jOaSbA/Impedantie-onafhankelijke-stroombron-ontvanger/Images/20260116_134800.jpg

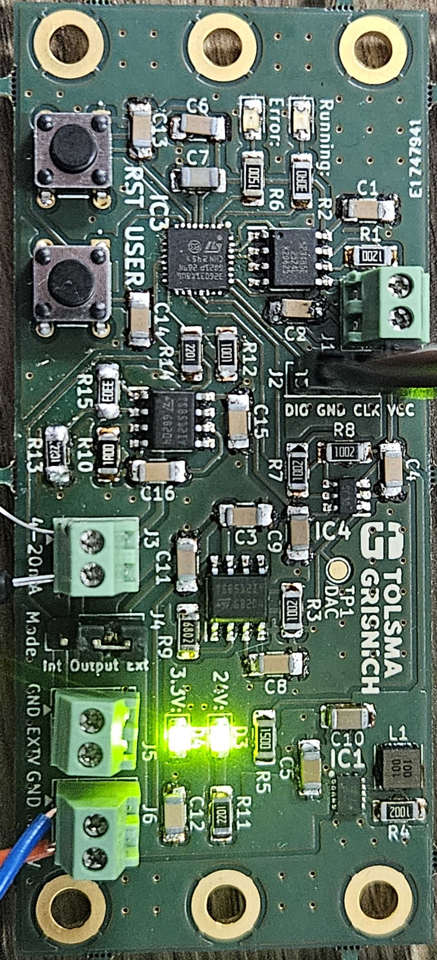
Images/20260116_134800.jpg
