jOaSbA/Impedantie-onafhankelijke-stroombron-ontvanger/README.md

"# Impedantie-onafhankelijke-stroombron-ontvanger"
