jOaSbA/Impedantie-onafhankelijke-stroombron-ontvanger/(list of files, drawings)

Other design files:
KiCad/freerouting.dsn
KiCad/temp-freerouting.dsn
