jOaSbA/Impedantie-onafhankelijke-stroombron-ontvanger/KiCad/Tolsma-Grisnich_4-20mAstrmbrn.kicad_pcb

## KiCad design KiCad/Tolsma-Grisnich_4-20mAstrmbrn.kicad_pcb (2026-01-16)

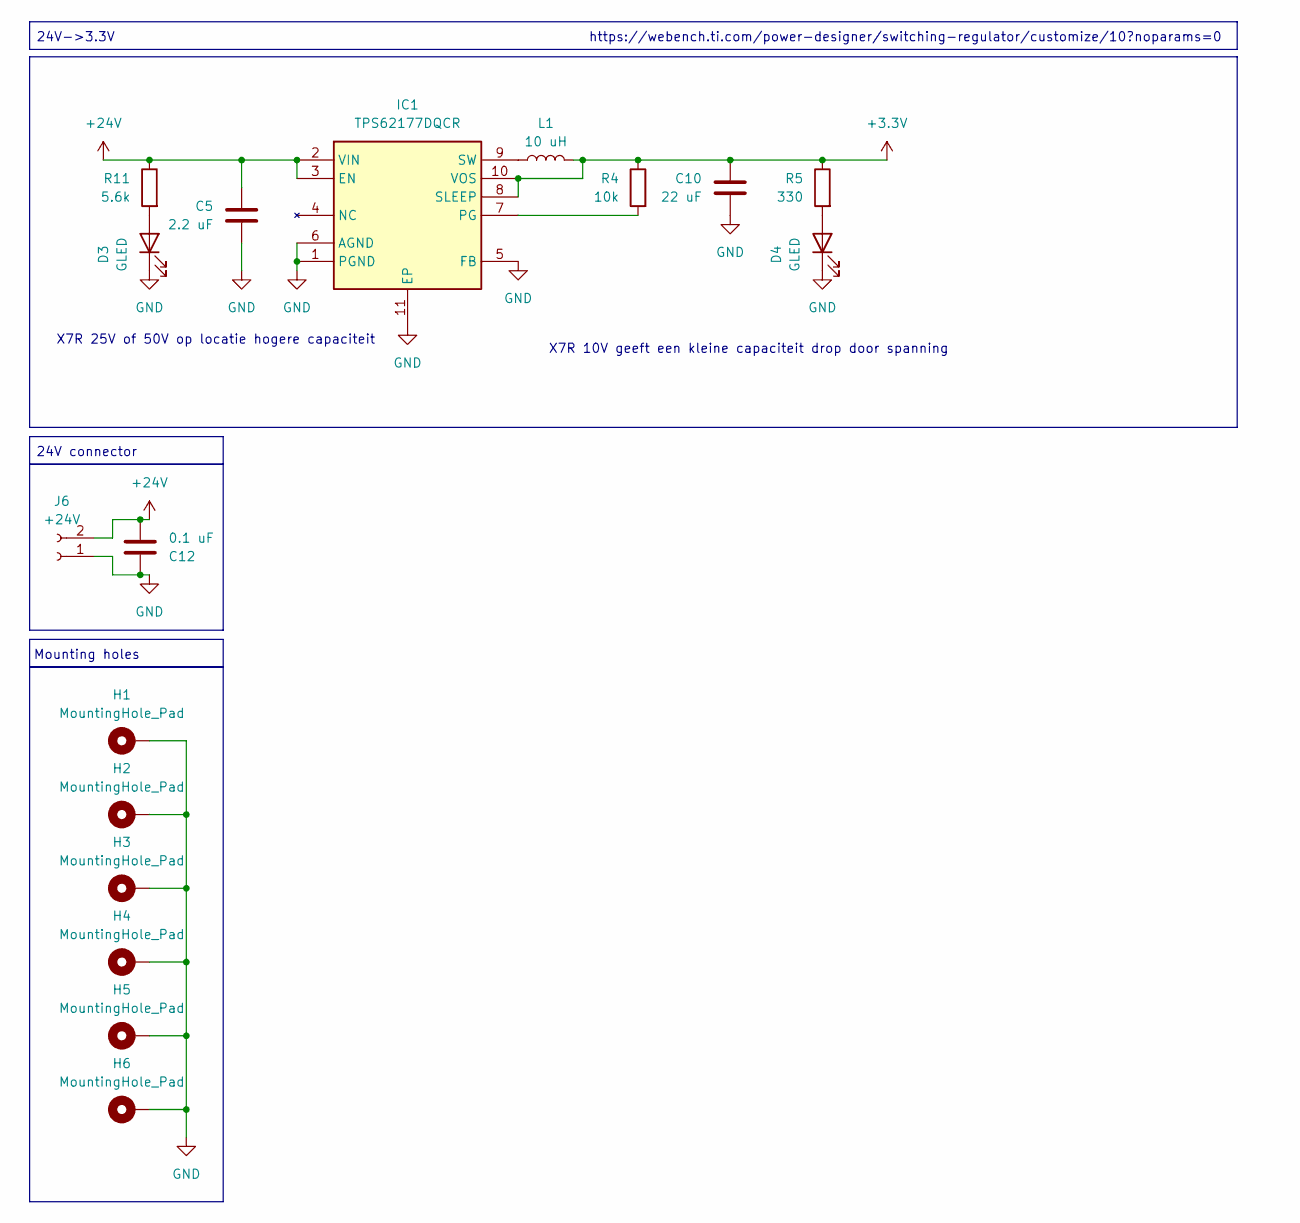
[picture p2: schematic Power.kicad_sch]

Parts:
C5: 2.2 uF; C_1206_3216Metric_Pad1.33x1.80mm_HandSolder
C10: 22 uF; C_1206_3216Metric_Pad1.33x1.80mm_HandSolder
C12: 0.1 uF; C_1206_3216Metric_Pad1.33x1.80mm_HandSolder
D3, D4: GLED; LED_0805_2012Metric_Pad1.15x1.40mm_HandSolder
H1, H2, H3, H4, H5, H6: MountingHole_Pad; MountingHole_3.2mm_M3_DIN965_Pad
IC1: TPS62177DQCR; SON50P200X300X80-11N; Mouser Part Number 595-TPS62177DQCR
J6: +24V; TerminalBlock_Xinya_XY308-2.54-2P_1x02_P2.54mm_Horizontal
L1: 10 uH; L_Wuerth_MAPI-3015
R4: 10k; R_1206_3216Metric_Pad1.30x1.75mm_HandSolder
R5: 330; R_1206_3216Metric_Pad1.30x1.75mm_HandSolder
R11: 5.6k; R_1206_3216Metric_Pad1.30x1.75mm_HandSolder

Connections:
+3.3V: C10.1, IC1.8 (SLEEP), IC1.10 (VOS), L1.2, R4.1, R5.1; also elsewhere on the board
+24V: C5.1, C12.2, IC1.2 (VIN), IC1.3 (EN), J6.2, R11.1; also elsewhere on the board
GND: C5.2, C10.2, C12.1, D3.1 (K), D4.1 (K), H1.1, H2.1, H3.1, H4.1, H5.1, H6.1, IC1.1 (PGND), IC1.5 (FB), IC1.6 (AGND), IC1.11 (EP), J6.1; also elsewhere on the board
unnamed: D3.2 (A), R11.2
unnamed: D4.2 (A), R5.2
unnamed: IC1.7 (PG), R4.2
unnamed: IC1.9 (SW), L1.1

Notes on the sheet:
X7R 10V geeft een kleine capaciteit drop door spanning
24V connector
24V->3.3V
Mounting holes
X7R 25V of 50V op locatie hogere capaciteit
https://webench.ti.com/power-designer/switching-regulator/customize/10?noparams=0

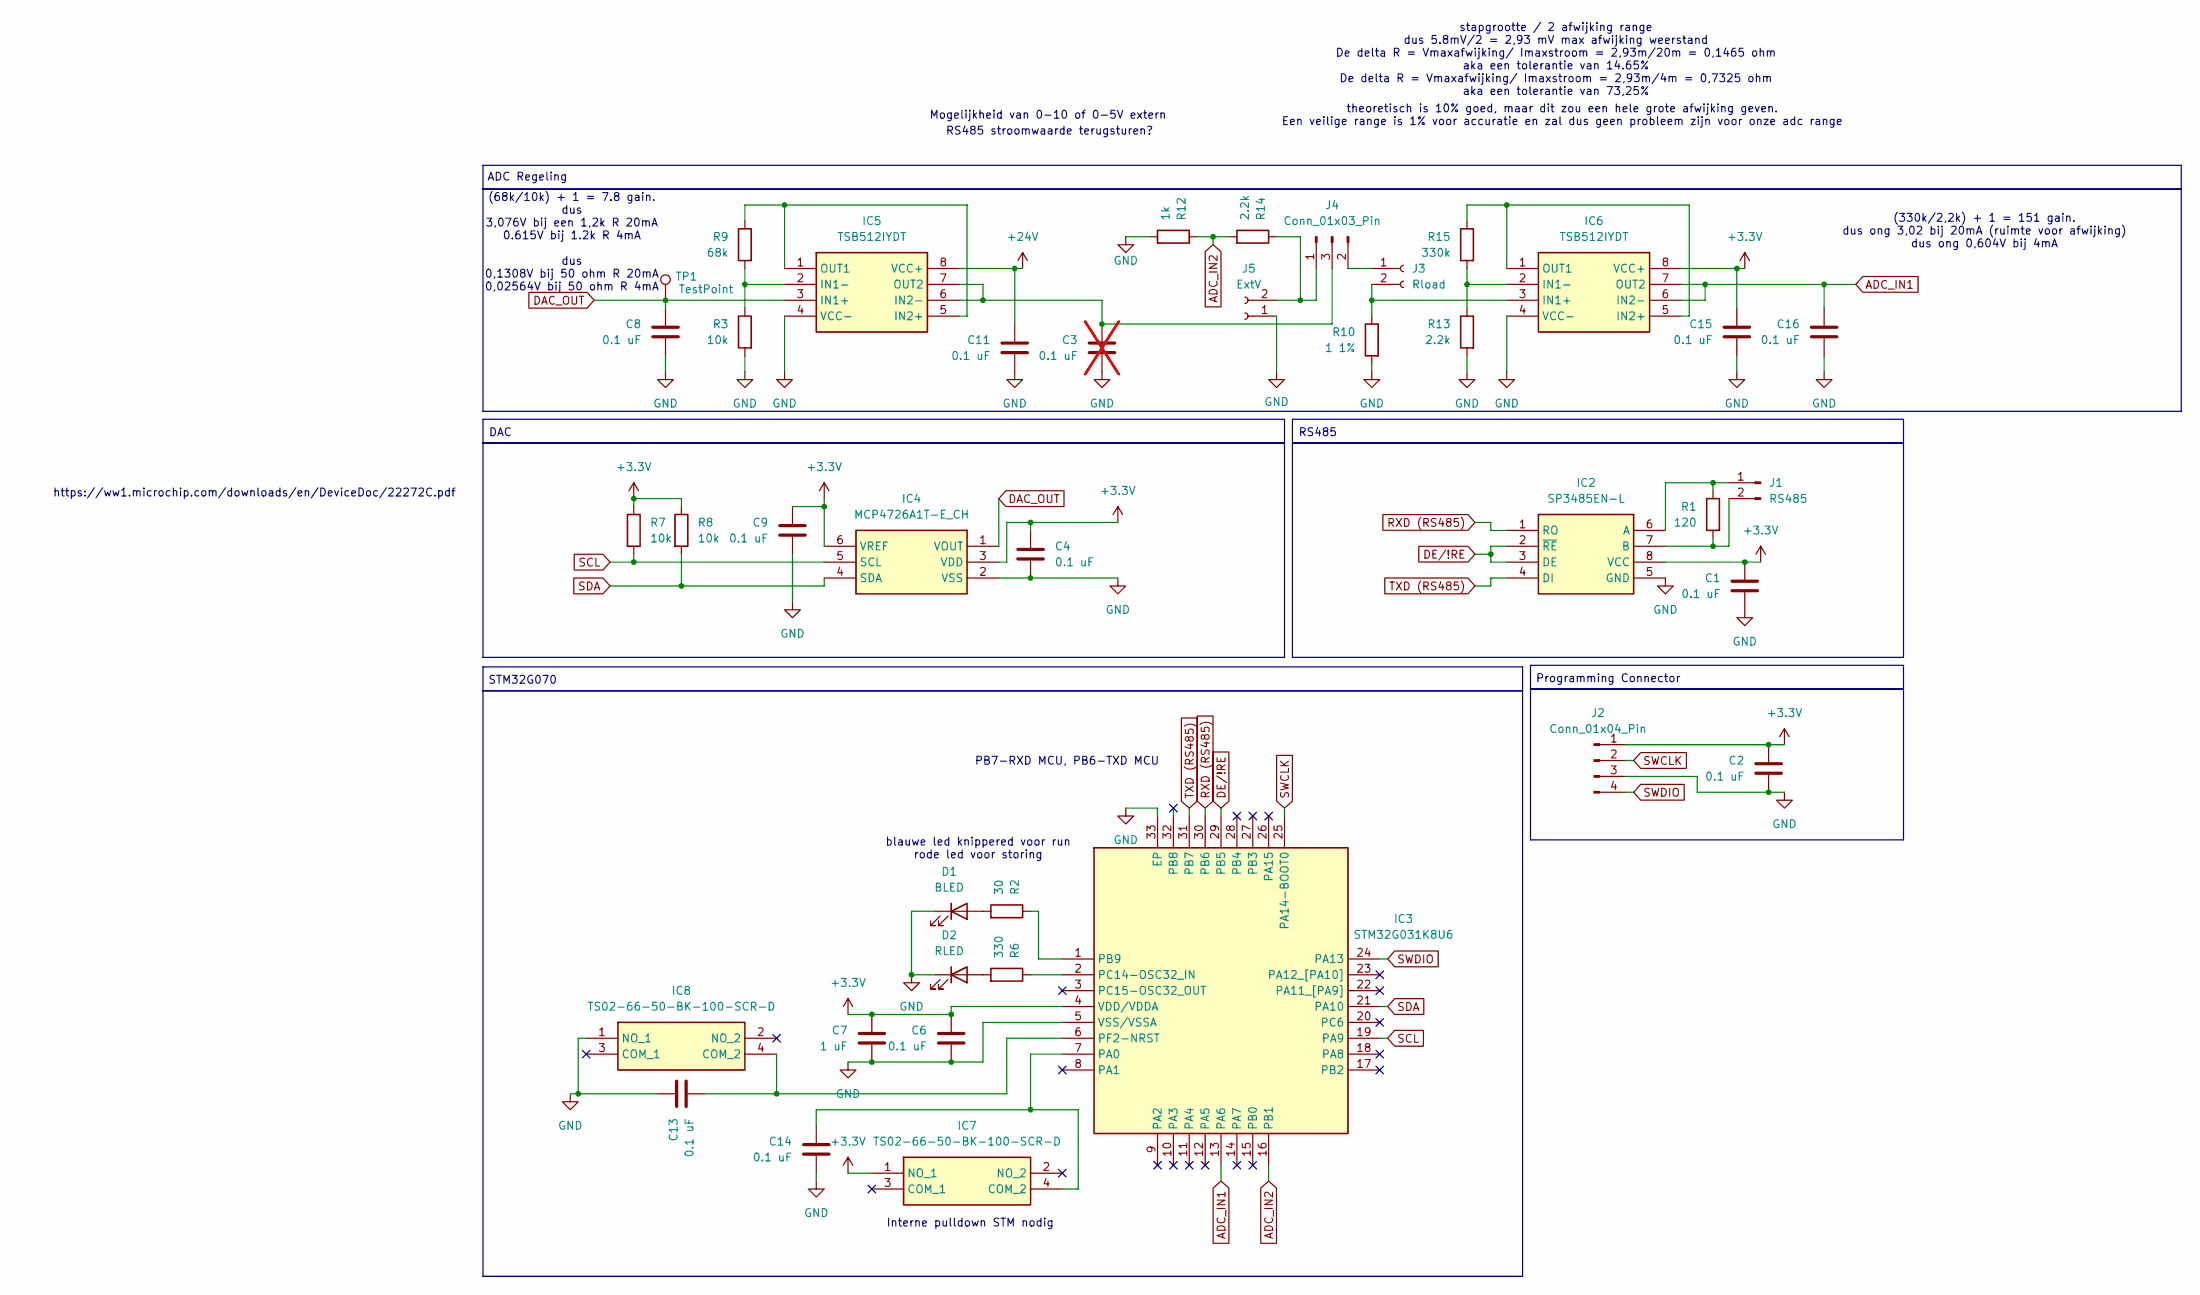
[picture p3: schematic Logic.kicad_sch]

Parts:
C1, C2, C4, C6, C8, C9, C11, C13, C14, C15, C16: 0.1 uF; C_1206_3216Metric_Pad1.33x1.80mm_HandSolder
C3: 0.1 uF; C_1206_3216Metric_Pad1.33x1.80mm_HandSolder; not fitted
C7: 1 uF; C_1206_3216Metric_Pad1.33x1.80mm_HandSolder
D1: BLED; LED_0805_2012Metric_Pad1.15x1.40mm_HandSolder
D2: RLED; LED_0805_2012Metric_Pad1.15x1.40mm_HandSolder
IC2: SP3485EN-L; SOIC127P600X175-8N; Manufacturer_Part_Number SP3485EN-L; Mouser Part Number 701-SP3485EN-L
IC3: STM32G031K8U6; QFN50P500X500X60-33N-D; Mouser Part Number 511-STM32G031K8U6
IC4: MCP4726A1T-E_CH; SOT95P270X145-6N; Manufacturer_Part_Number MCP4726A1T-E/CH; Mouser Part Number 579-MCP4726A1TECH
IC5, IC6: TSB512IYDT; SOIC127P600X175-8N; Manufacturer_Part_Number TSB512IYDT; Mouser Part Number 511-TSB512IYDT
IC7, IC8: TS02-66-50-BK-100-SCR-D; TS026650BK100SCRD; Mouser Part Number 179-TS026650BK100SCR
J1: RS485; TerminalBlock_Xinya_XY308-2.54-2P_1x02_P2.54mm_Horizontal
J2: Conn_01x04_Pin; PinHeader_1x04_P2.54mm_Vertical
J3: Rload; TerminalBlock_Xinya_XY308-2.54-2P_1x02_P2.54mm_Horizontal
J4: Conn_01x03_Pin; PinHeader_1x03_P2.54mm_Vertical
J5: ExtV; TerminalBlock_Xinya_XY308-2.54-2P_1x02_P2.54mm_Horizontal
R1: 120; R_1206_3216Metric_Pad1.30x1.75mm_HandSolder
R2: 30; R_1206_3216Metric_Pad1.30x1.75mm_HandSolder
R3, R7, R8: 10k; R_1206_3216Metric_Pad1.30x1.75mm_HandSolder
R6: 330; R_1206_3216Metric_Pad1.30x1.75mm_HandSolder
R9: 68k; R_1206_3216Metric_Pad1.30x1.75mm_HandSolder
R10: 1 1%; R_1206_3216Metric_Pad1.30x1.75mm_HandSolder
R12: 1k; R_1206_3216Metric_Pad1.30x1.75mm_HandSolder
R13, R14: 2.2k; R_1206_3216Metric_Pad1.30x1.75mm_HandSolder
R15: 330k; R_1206_3216Metric_Pad1.30x1.75mm_HandSolder
TP1: TestPoint; TestPoint_Pad_D1.5mm

Connections:
+3.3V: C1.1, C2.1, C4.1, C6.1, C7.1, C9.1, C15.1, IC2.8 (VCC), IC3.4 (VDD/VDDA), IC4.3 (VDD), IC4.6 (VREF), IC6.8 (VCC+), IC7.1 (NO_1), J2.1, R7.1, R8.1; also elsewhere on the board
+24V: C11.1, IC5.8 (VCC+); also elsewhere on the board
ADC_IN1: C16.1, IC3.13 (PA6), IC6.6 (IN2-), IC6.7 (OUT2)
ADC_IN2: IC3.16 (PB1), R12.1, R14.2
DAC_OUT: C8.1, IC4.1 (VOUT), IC5.3 (IN1+), TP1.1
DE/!RE: IC2.2 (~RE), IC2.3 (DE), IC3.29 (PB5)
GND: C1.2, C2.2, C3.2, C4.2, C6.2, C7.2, C8.2, C9.2, C11.2, C13.1, C14.2, C15.2, C16.2, D1.1 (K), D2.1 (K), IC2.5 (GND), IC3.5 (VSS/VSSA), IC3.33 (EP), IC4.2 (VSS), IC5.4 (VCC-), IC6.4 (VCC-), IC8.1 (NO_1), J2.3, J5.1, R3.2, R10.2, R12.2, R13.2; also elsewhere on the board
unnamed: D1.2 (A), R2.2
unnamed: D2.2 (A), R6.2
unnamed: IC2.6 (A), J1.1, R1.1
unnamed: IC2.7 (B), J1.2, R1.2
unnamed: C14.1, IC3.7 (PA0), IC7.4 (COM_2)
unnamed: IC3.1 (PB9), R2.1
unnamed: IC3.2 (PC14-OSC32_IN), R6.1
unnamed: C13.2, IC3.6 (PF2-NRST), IC8.4 (COM_2)
unnamed: IC5.2 (IN1-), R3.1, R9.2
unnamed: IC5.1 (OUT1), IC5.5 (IN2+), R9.1
unnamed: C3.1, IC5.6 (IN2-), IC5.7 (OUT2), J4.3
unnamed: IC6.3 (IN1+), J3.2, R10.1
unnamed: IC6.2 (IN1-), R13.1, R15.2
unnamed: IC6.1 (OUT1), IC6.5 (IN2+), R15.1
unnamed: J3.1, J4.2
unnamed: J4.1, J5.2, R14.1
RXD (RS485): IC2.1 (RO), IC3.30 (PB6)
SCL: IC3.19 (PA9), IC4.5 (SCL), R7.2
SDA: IC3.21 (PA10), IC4.4 (SDA), R8.2
SWCLK: IC3.25 (PA14-BOOT0), J2.2
SWDIO: IC3.24 (PA13), J2.4
TXD (RS485): IC2.4 (DI), IC3.31 (PB7)

Notes on the sheet:
theoretisch is 10% goed, maar dit zou een hele grote afwijking geven. Een veilige range is 1% voor accuratie en zal dus geen probleem zijn voor onze adc range
(68k/10k) + 1 = 7.8 gain. dus 3,076V bij een 1,2k R 20mA 0.615V bij 1.2k R 4mA dus 0,1308V bij 50 ohm R 20mA 0,02564V bij 50 ohm R 4mA
ADC Regeling
Programming Connector
blauwe led knippered voor run rode led voor storing
RS485 stroomwaarde terugsturen?
STM32G070
DAC
stapgrootte / 2 afwijking range dus 5.8mV/2 = 2,93 mV max afwijking weerstand De delta R = Vmaxafwijking/ Imaxstroom = 2,93m/20m = 0,1465 ohm aka een tolerantie van 14.65% De delta R = Vmaxafwijking/ Imaxstroom = 2,93m/4m = 0,7325 ohm aka een tolerantie van 73,25%
Mogelijkheid van 0-10 of 0-5V extern
(330k/2,2k) + 1 = 151 gain. dus ong 3,02 bij 20mA (ruimte voor afwijking) dus ong 0,604V bij 4mA
Interne pulldown STM nodig
https://ww1.microchip.com/downloads/en/DeviceDoc/22272C.pdf
PB7-RXD MCU, PB6-TXD MCU
RS485

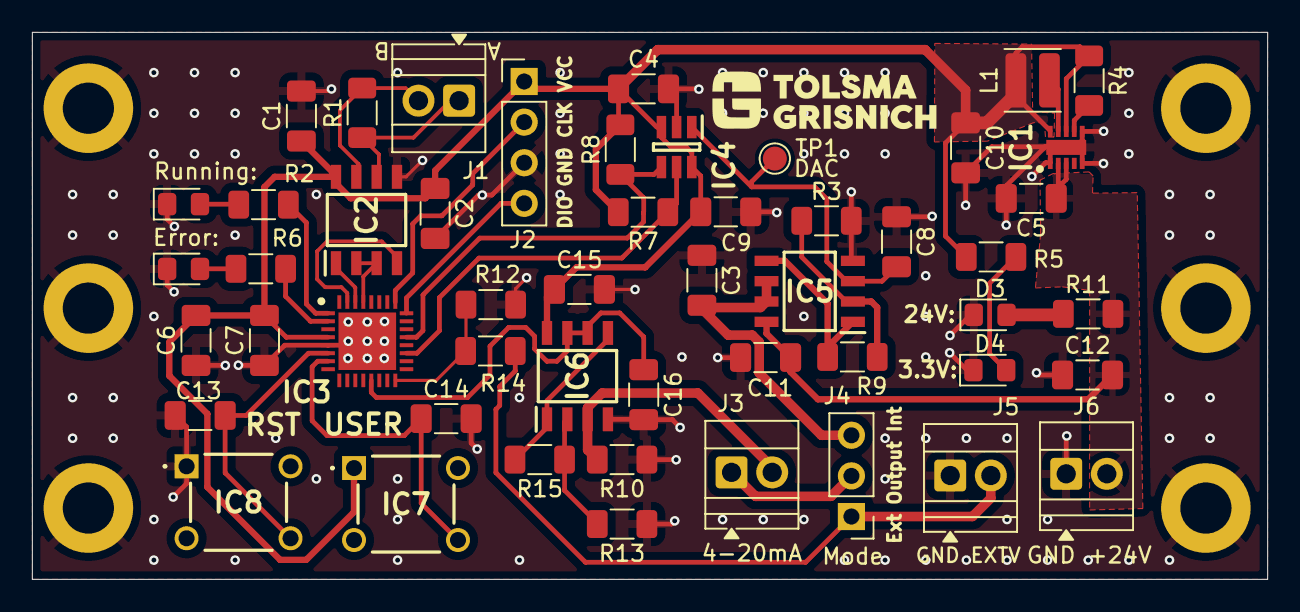
[picture p4: board Tolsma-Grisnich_4-20mAstrmbrn.kicad_pcb from above]

Board: 2 copper layers, 77.2 x 34.2 mm, 57 parts (0 on the bottom side), 33 nets.
