jOaSbA/Impedantie-onafhankelijke-stroombron-ontvanger/CubeIO/Tolsma-GrisnichCurrent.ioc

Mcu.UserName=STM32G031K8Ux
PA0.Signal=GPIO_Input
PA10.Signal=I2C1_SDA
PA13.Signal=SYS_SWDIO
PA14-BOOT0.Signal=SYS_SWCLK
PA6.Signal=ADC1_IN6
PA9.Signal=I2C1_SCL
PB1.Signal=ADC1_IN9
PB5.GPIO_Label=DE/\!RE
PB5.Signal=GPIO_Output
PB6.Signal=USART1_TX
PB7.Signal=USART1_RX
PB9.Signal=GPIO_Output
