jOaSbA/Impedantie-onafhankelijke-stroombron-ontvanger/(commit log)

2026-01-06 DMA UART plus regeling in task
2026-01-07 DAC driver geschreven
2026-01-07 ADCtoStroom geschreven en bugfixes
    [main.c]
2026-01-16 PI tuning, error is 10 lsb
    [main.c]
2026-01-16 Kicad en image toegevoegd
    [Logic.kicad_sch, Power.kicad_sch, Prod-4-20mA-Tolsma-Grisnich_bom.csv, Prod-4-20mA-Tolsma-Grisnich_designators.csv, Prod-4-20mA-Tolsma-Grisnich_positions.csv, Tolsma-Grisnich_4-20mAstrmbrn.kicad_pcb, Tolsma-Grisnich_4-20mAstrmbrn.kicad_sch, freerouting.dsn]
2026-01-19 Mode wisseling, waardes gekalibreerd, werkende RS485, PI regeling verbeterd, led geimplementeerd, veiligere FreeRTOS operatie
    [Logic.kicad_sch, Power.kicad_sch]
